LonghornRacingElectric/BSPD_2023/23-BSPD-ELC/22-ELC-2-01-R1 BOM MOUSER.xlsx

Source: | C:\Users\kaits\Documents\GitHub\2022_hardware\22-ELC-2000 (Controls and Harnessing)\22-ELC-2-06-R1(Appetizer)\20-ELC-2-01-R2(Appetizer).sch
Date: | 2022-01-13 |  | Mouser BSPD BOM |  | Shipping Cost ~$8 | Total Cost: $17.49
Tool: | Eeschema (5.1.10)-1
Component Count: |  | 19
Component |  | Designator | Footprint | Manufacturer |  |  | Manufacturer Pt#: | Mouser Pt#: | Quantity: | Quanity w/ Replacements:
1A |  | F1 | 1206 | Littelfuse |  |  | 0437001.WR | 530-C1Q1.25 | 1 | 2
LM239 |  | U1, U2, U5 | SO-14 | STMicroelectronics |  |  | LM239DT | 511-LM239DT | 4 | 6
74HC04 |  | U7 | SOIC-14_3.9x8.7x1.27P | Texas Instruments |  |  | CD40106BM96 | 595-CD40106BM96 | 2 | 3
IMP810JEUR_T |  | VR1 | SOT-23-3 | Daily Silver Imp Microelectronics |  |  | IMP810LEUR/T | 453-DIO6810RST3 | 1 | 2
CD4043BDRG4 |  | U10 | SOIC-16_3.9x9.9x1.27P | Texas Instruments |  |  | CD4043BDRG4 | 595-CD4043BDRG4 | 1
R_POT_TRIM |  | RV1, RV2, RV3, RV4, RV5, RV6, RV7, RV8, RV24, RV27, RV29, RV32 | 3269Wl | Bourns |  |  | PVG5A104C03R00 | 81-PVG5A104C03R00 | 12 | 16
Pin Headers |  | J1, J2 | Connector_PinHeader_2.54mm:PinHeader_1x05_P2.54mm_Vertical | Harwin |  |  | M20-9990945 | 855-M20-9990945 | 1 | 5
