LonghornRacingElectric/BSPD_2023/23-BSPD-ELC/20-ELC-2-06-R2(Appetizer)_layout.pdf

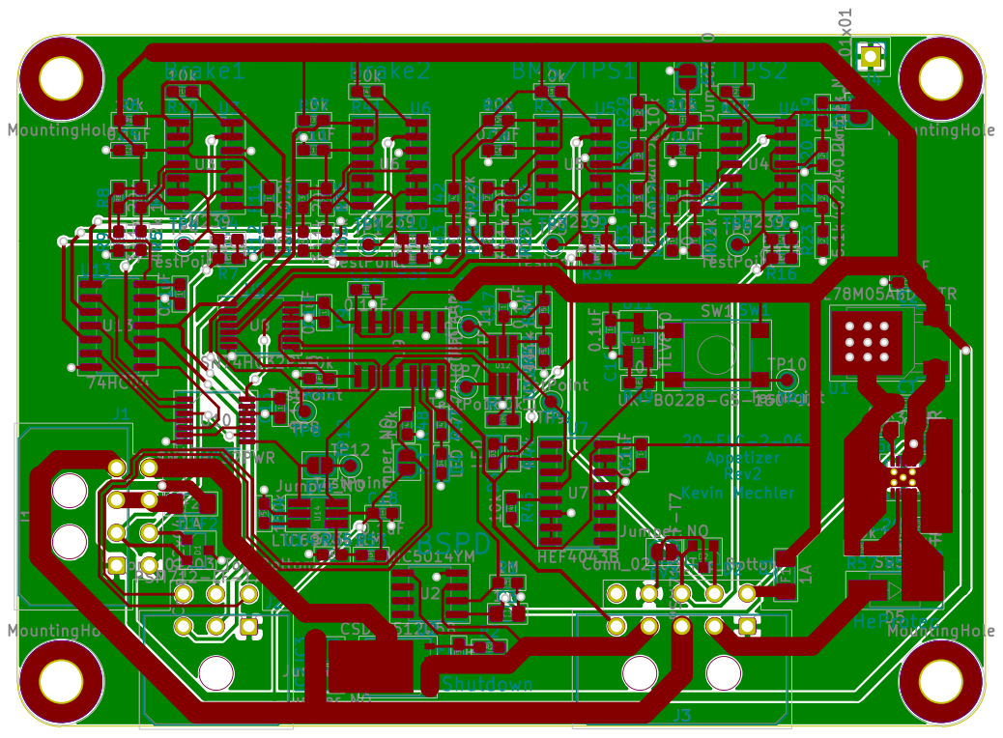
[picture p11: page 1]
