LonghornRacingElectric/BSPD_2023/23-BSPD-ELC/Short_Detector.asc

C1: cap; 0.1µf
C2: cap; 0.1µf
C3: cap; 0.1µf
C4: cap; 0.0014µf
D1: diode; 1N4148
Q1: npn
R1: res; 1k
R2: res; 10k
R3: res; 1Mega
R4: res; 425k
R5: res; 200k
R6: res; 51k
R7: res; 22k
R8: res; 50
R9: res; 2k
U1: LT1716
U2: NE555
V1: voltage; PULSE(0 5 0 100ns 100ns 0.1ms 0.2ms 1000)
V2: voltage; 5
V3: voltage; 5
V4: voltage; 5
V5: voltage; PULSE(0 5 0 100ns 100ns 300ms 600ms)
Named nets: 0
.tran 3s
