LonghornRacingElectric/BSPD_2023/23-BSPD-ELC/20-ELC-2-01-R2(Appetizer).kicad_pcb

## KiCad design 23-BSPD-ELC/20-ELC-2-01-R2(Appetizer).kicad_pcb (2023-01-10)

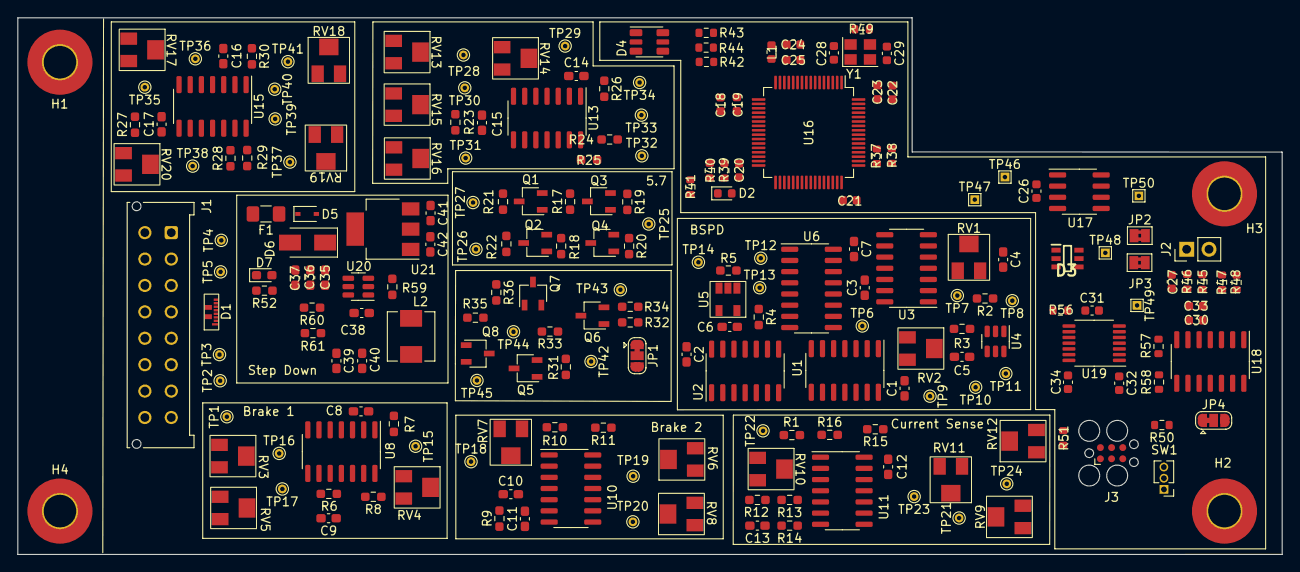
[picture p12: board 20-ELC-2-01-R2(Appetizer).kicad_pcb from above]

Board: 2 copper layers, 143.6 x 61.0 mm, 218 parts (0 on the bottom side), 109 nets, no tracks yet.

Parts:
C1, C2, C3, C6, C7, C8, C9, C10, C11, C12, C13, C14, C15, C16, C17: 0.1uF; C_0603_1608Metric_Pad1.08x0.95mm_HandSolder
C4, C5, C39, C40, C42: 22uF; C_0603_1608Metric_Pad1.08x0.95mm_HandSolder
C18: 4u7; C_0603_1608Metric
C19, C20, C21, C22, C23: 100n; C_0603_1608Metric
C24: 1u; C_0603_1608Metric
C25: 10n; C_0603_1608Metric
C26: 0u1; C_0603_1608Metric
C27: 4.7n; C_0603_1608Metric
C28, C29: 10p; C_0603_1608Metric
C30, C32, C34: .1uF; C_0603_1608Metric
C31: 1uF; C_0603_1608Metric
C33: 10uF; C_0603_1608Metric
C35, C36: 10uF; C_0603_1608Metric_Pad1.08x0.95mm_HandSolder
C37, C38: 100nF; C_0603_1608Metric_Pad1.08x0.95mm_HandSolder
C41: 1uF; C_0603_1608Metric_Pad1.08x0.95mm_HandSolder
D1: ESD7016MUTAG
D2: RED; LED_0603_1608Metric
D3: DT1446-04TS-7; SOT95P280X100-6N
D4: SMLVN6RGB; LED_ROHM_SMLVN6
D5: 32V; D_SOD-323
D6: 0.7dV; D_SMA
D7: LED; LED_0603_1608Metric_Pad1.05x0.95mm_HandSolder
F1: 2A; Fuse_1206_3216Metric_Pad1.42x1.75mm_HandSolder
H1, H2, H3, H4: MountingHole; MountingHole_3.7mm_Pad_TopBottom
J1: Conn_02x08_Counter_Clockwise; Molex_Micro-Fit_3.0_43045-1612_2x08_P3.00mm_Vertical
J2: Conn_01x02; PinHeader_1x02_P2.54mm_Vertical
J3: SWD; Tag-Connect_TC2030-IDC-FP_2x03_P1.27mm_Vertical
JP1, JP4: Jumper_3_Bridged12; SolderJumper-3_P1.3mm_Bridged12_RoundedPad1.0x1.5mm
JP2, JP3: SolderJumper-2_P1.3mm_Bridged2Bar_Pad1.0x1.5mm
L1: 68n; L_0603_1608Metric
L2: 4u7; L_Sunlord_MWSA0518_5.4x5.2mm
Q1, Q2: Q_PMOS_GSD; TSOT-23
Q3, Q4, Q5, Q6: Q_NMOS_GSD-Device; TSOT-23
Q7, Q8: Q_PMOS_DSG; TSOT-23
R1, R2, R3, R4, R7, R8, R10, R11, R15, R16, R17, R19, R20, R21, R22, R24, R25, R26, R28, R29, R30, R33, R34, R35, R36: 10k; R_0603_1608Metric_Pad0.98x0.95mm_HandSolder
R5: 100k; R_0603_1608Metric_Pad0.98x0.95mm_HandSolder
R6, R9, R12: 510k; R_0603_1608Metric_Pad0.98x0.95mm_HandSolder
R13, R14: 150; R_0603_1608Metric_Pad0.98x0.95mm_HandSolder
R18: 250; R_0603_1608Metric_Pad0.98x0.95mm_HandSolder
R23, R27: 510; R_0603_1608Metric_Pad0.98x0.95mm_HandSolder
R31, R32: 25; R_0603_1608Metric_Pad0.98x0.95mm_HandSolder
R37, R38, R39, R40: 2k2; R_0603_1608Metric
R41: 100; R_0603_1608Metric
R42, R43, R44: 220; R_0603_1608Metric
R45, R46, R47, R48: 120; R_0603_1608Metric
R49: 47; R_0603_1608Metric
R50: 10K; R_0603_1608Metric
R51: 22; R_0603_1608Metric
R52: 470R; R_0603_1608Metric_Pad0.98x0.95mm_HandSolder
R56: 100k; R_0603_1608Metric
R57, R58: 10k; R_0603_1608Metric
R59, R60: 10K; R_0603_1608Metric_Pad0.98x0.95mm_HandSolder
R61: 54.9K; R_0603_1608Metric_Pad0.98x0.95mm_HandSolder
RV1, RV2, RV3, RV4, RV5, RV6, RV7, RV8, RV9, RV10, RV11, RV12: PVG5A104C03R00; PVG5A
RV13, RV14, RV17, RV18: 10k; PVG5A
RV15, RV16, RV19, RV20: R_POT_TRIM-Device; PVG5A
SW1: SW_SPDT; PinHeader_1x03_P1.27mm_Vertical
TP1, TP2, TP3, TP4, TP5, TP26, TP27, TP42, TP43, TP44, TP45: TestPoint-Connector; TestPoint_THTPad_D1.0mm_Drill0.5mm
TP6, TP7, TP8, TP9, TP10, TP11, TP12, TP13, TP14, TP15, TP16, TP17, TP18, TP19, TP20, TP21, TP22, TP23, TP24, TP25, TP28, TP29, TP30, TP31, TP32, TP33, TP34, TP35, TP36, TP37, TP38, TP39, TP40, TP41: TestPoint; TestPoint_THTPad_D1.0mm_Drill0.5mm
TP46, TP47, TP48, TP49, TP50: TestPoint_THTPad_1.0x1.0mm_Drill0.5mm
U1: SN74ALS32DR; SOIC-14_3.9x8.7mm_P1.27mm
U2: 74HC04D,653; SO-14_3.9x8.65mm_P1.27mm
U3: 74HC08D,653; SOIC-14_3.9x8.7mm_P1.27mm
U4: 74LVC2G17DBVE4; SOT-23-6
U5: APX823-44W5G-7; AXP823-44W5G-7
U6: CD4043BDR; SOIC-16_3.9x9.9mm_P1.27mm
U8, U10, U11, U13, U15: LM239; SO-14_3.9x8.65mm_P1.27mm
U16: STM32F105RCTx; LQFP-64_10x10mm_P0.5mm
U17: SN65HVD230; SOIC-8_3.9x4.9mm_P1.27mm
U18: MCP3428; SOIC-14_3.9x8.7mm_P1.27mm
U19: LSF0204QPWRQ1; TSSOP-14_4.4x5mm_P0.65mm
U20: LMR51420; SOT-23-6
U21: AMS1117-3.3; SOT-223-3_TabPin2
Y1: 16MHz; Crystal_SMD_3225-4Pin_3.2x2.5mm

Connections:
+3.3VA: C24.1, C25.1, L1.2, U16.13 (VDDA)
+3V3: C18.1, C19.1, C20.1, C21.1, C22.1, C23.1, C26.1, C32.1, C42.1, D2.2 (A), D4.1 (BA), D4.2 (RA), D4.3 (GA), J3.1, L1.1, R37.1, R38.1, R39.1, R40.1, R56.2, SW1.1 (A), U16.1 (VBAT), U16.19 (VDD), U16.32 (VDD), U16.48 (VDD), U16.64 (VDD), U17.3 (VCC), U19.1 (VREF_A), U21.2 (VO)
+5V: C1.1, C2.1, C3.1, C6.1, C7.1, C8.1, C10.1, C12.1, C14.1, C16.1, C30.1, C33.1, C34.1, C39.1, C40.1, C41.1, D3.5 (VCC), L2.2, R4.2, R7.2, R8.1, R10.2, R11.1, R15.2, R16.1, R24.1, R25.1, R26.1, R28.1, R29.1, R30.1, R57.2, R58.2, R61.2, RV3.1, RV4.1, RV5.1, RV6.1, RV7.1, RV8.1, RV9.1, RV10.1, RV11.1, RV12.1, RV13.1, RV14.1, RV15.1, RV16.1, RV17.1, RV18.1, RV19.1, RV20.1, U1.14 (VCC), U2.14 (VCC), U3.14 (Vcc), U4.5 (VCC), U5.5 (Vcc), U6.16 (Vdd), U8.3 (V+), U10.3 (V+), U11.3 (V+), U13.3 (V+), U15.3 (V+), U18.6 (VDD), U19.14 (VREF_B), U21.3 (VI)
+24V: F1.2, J1.1
/5.7/APPS_Trip: Q3.1 (G), Q4.1 (G), R19.2, R20.2, TP25.1, U16.40 (PC9)
/5.7/APPs1_Out: Q1.3 (D), R21.2, TP27.1
/5.7/APPs2_Out: Q2.3 (D), R22.2, TP26.1
/5.7/microcontroller/BOOT0: R50.2, U16.60 (BOOT0)
/5.7/microcontroller/CAN1_RX: TP47.1, U16.61 (PB8), U17.4 (R)
/5.7/microcontroller/CAN1_TX: TP46.1, U16.62 (PB9), U17.1 (D)
/5.7/microcontroller/HSE_in: C28.1, U16.5 (PD0), Y1.1
/5.7/microcontroller/HSE_out: R49.1, U16.6 (PD1)
/5.7/microcontroller/I2C1_SCL: R37.2, U16.58 (PB6)
/5.7/microcontroller/I2C1_SDA: R38.2, U16.59 (PB7)
/5.7/microcontroller/I2C2_SCL: R39.2, U16.29 (PB10)
/5.7/microcontroller/I2C2_SDA: R40.2, U16.30 (PB11)
/5.7/microcontroller/LED_B: R42.2, U16.16 (PA2)
/5.7/microcontroller/LED_G: R43.2, U16.15 (PA1)
/5.7/microcontroller/LED_R: R44.2, U16.14 (PA0)
/5.7/microcontroller/SWCLK: J3.4, U16.49 (PA14)
/5.7/microcontroller/SWDIO: R51.2, U16.46 (PA13)
/24 to 5V Step Down/BUCK/EN: R59.2, U20.5 (EN)
/24 to 5V Step Down/BUCK/SW: C38.1, L2.1, U20.2 (SW)
/24 to 5V Step Down/BUCK/VBST: C38.2, U20.6 (VBST)
/24 to 5V Step Down/BUCK/VFB: R60.1, R61.1, U20.4 (VFB)
/24 to 5V Step Down/BUCK/V_in: C35.1, C36.1, C37.1, D6.1 (K), D7.2 (A), R59.1, U20.3 (VIN)
/24 to 5V Step Down/DIODE: D5.1 (K), D6.2 (A), F1.1
/APPs1_5%: R25.2, TP32.1, U13.14, U16.39 (PC8)
/APPs1_25%: R24.2, TP33.1, U13.13, U16.10 (PC2)
/APPs1_Connected: R26.2, TP34.1, U13.1, U13.2, U16.38 (PC7)
/APPs1_Signal_Raw: C15.1, D1.7 (I/O5), J1.2, Q1.2 (S), R17.2, R23.1, TP4.1, U13.5 (+), U13.6 (-), U13.8 (-), U13.11 (+)
/APPs2_5%: R29.2, TP39.1, U15.14, U16.8 (PC0)
/APPs2_25%: R28.2, TP40.1, U15.13, U16.11 (PC3)
/APPs2_Connected: R30.2, TP41.1, U15.1, U15.2, U16.37 (PC6)
/APPs2_Signal_Raw: C17.1, D1.8 (I/O6), J1.3, Q2.2 (S), R18.2, R27.1, TP5.1, U15.5 (+), U15.6 (-), U15.8 (-), U15.11 (+)
/BMS Signal/DataRaw_Half: R13.1, R14.1, U11.5 (+), U11.6 (-), U11.9 (+), U11.10 (-)
/BSPD_Reset: J1.7, U5.3 (~MR)
/Brake1 Signal/Vref_4V: RV3.2, TP16.1, U8.7 (+), U8.11 (+)
/Brake1_Connected: R8.2, U2.1, U8.13, U8.14
/Brake1_Signal: J1.15, R7.1, U1.1, U8.1, U8.2, U16.25 (PC5)
/Brake1_Signal_Raw: C9.1, D1.4 (I/O3), J1.4, R6.2, TP2.1, U8.5 (+), U8.6 (-), U8.9 (+), U8.10 (-)
/Brake2 Signal/Vref_4V: RV6.2, TP19.1, U10.7 (+), U10.11 (+)
/Brake2_Connected: R11.2, U2.3, U10.13, U10.14
/Brake2_Signal: R10.1, U1.2, U2.9, U10.1, U10.2, U16.24 (PC4)
/Brake2_Signal_Raw: C11.1, D1.2 (I/O2), J1.5, R9.2, TP1.1, U10.5 (+), U10.6 (-), U10.9 (+), U10.10 (-)
/BrakeSystemPlausibilityDevice/Power_and_Brakes: RV1.1, TP7.1, U3.3 (1Y)
/BrakeSystemPlausibilityDevice/Power_and_Brakes_TRIP: TP11.1, U1.4, U4.6
/BrakeSystemPlausibilityDevice/SET: R5.1, TP13.1, U5.1 (~Reset), U6.4 (S1)
/BrakeSystemPlausibilityDevice/Signal_Lost: RV2.1, U1.11
/BrakeSystemPlausibilityDevice/Signal_Lost_TRIP: TP10.1, U1.5, U4.4
/BrakeSystemPlausibilityDevice/TRIP: TP12.1, U1.6, U6.3 (R1)
/BrakeSystemPlausibilityDevice/~Brake1_Connected: U1.9, U2.2
/BrakeSystemPlausibilityDevice/~Brake2_Connected: U1.10, U2.4
/BrakeSystemPlausibilityDevice/~Brake_Connected: U1.8, U1.12
/BrakeSystemPlausibilityDevice/~CS_Connected: U1.13, U2.6
/CurrentSense_Connected: R15.1, U2.5, U11.13, U11.14
/CurrentSense_Signal: R1.1, R16.2, U3.1 (1A), U11.1, U11.2
/Current_Sense_Signal_Raw: C13.1, D1.1 (I/O1), J1.6, R12.2, R13.2, TP3.1
/Shutdown_IN: J1.11, Q7.3 (D), R36.1
/Shutdown_OUT: J1.10, Q8.2 (S), TP45.1
/VCU_Control: J1.9, JP1.3 (B)
/Watchdog/SCL: R58.1, U18.8 (SCL)
/Watchdog/SDA: R57.1, U18.7 (SDA)
/~BSPD_TRIPPED: JP1.1 (A), R32.1, TP14.1, U6.2 (Q1)
/~Brake2_Signal: J1.14, U2.8
GND: C1.2, C2.2, C3.2, C4.2, C5.2, C6.2, C7.2, C8.2, C9.2, C10.2, C11.2, C12.2, C13.2, C14.2, C15.2, C16.2, C17.2, C18.2, C19.2, C20.2, C21.2, C22.2, C23.2, C24.2, C25.2, C26.2, C27.1, C28.2, C29.2, C30.2, C31.2, C32.2, C33.2, C34.2, C35.2, C36.2, C37.2, C39.2, C40.2, C41.2, C42.2, D1.3 (VBUS_OR_GND), D3.2 (VSS), D5.2 (A), J1.8, J3.5, Q3.2 (S), Q4.2 (S), Q6.2 (S), R1.2, R2.2, R3.2, R5.2, R6.1, R9.1, R12.1, R14.2, R19.1, R20.1, R21.1, R22.1, R23.2, R27.2, R34.2, R41.2, R52.1, R60.2, RV3.3, RV4.3, RV5.3, RV6.3, RV7.3, RV8.3, RV9.3, RV10.3, RV11.3, RV12.3, RV13.3, RV14.3, RV15.3, RV16.3, RV17.3, RV18.3, RV19.3, RV20.3, SW1.3 (C), U1.7 (GND), U2.7 (GND), U2.11, U2.13, U3.4 (2A), U3.5 (2B), U3.7 (GND), U3.9 (3A), U3.10 (3B), U3.12 (4A), U3.13 (4B), U4.2 (GND), U5.2 (GND), U6.6 (S2), U6.7 (R2), U6.8 (Vss), U6.11 (R3), U6.12 (S3), U6.14 (S4), U6.15 (R4), U8.12 (V-), U10.12 (V-), U11.12 (V-), U13.12 (V-), U15.12 (V-), U16.12 (VSSA), U16.18 (VSS), U16.31 (VSS), U16.47 (VSS), U16.63 (VSS), U17.2 (GND), U17.8 (Rs), U18.2 (CH1-), U18.4 (CH2-), U18.5 (VSS), U18.9 (Adr0), U18.10 (Adr1), U18.12 (CH3-), U18.14 (CH4-), U19.7 (GND), U20.1 (GND), U21.1 (GND), Y1.2, Y1.4
unnamed: C4.1, R2.1, RV1.2, TP8.1, U4.1
unnamed: C5.1, R3.1, RV2.2, TP9.1, U4.3
unnamed: C27.2, J2.1, R45.1, R46.1
unnamed: C29.1, R49.2, Y1.3
unnamed: C31.1, R56.1, U19.8 (EN)
unnamed: D2.1 (K), R41.1
unnamed: D3.4 (I/O3), JP3.1 (A), R45.2, R46.2, TP49.1, U17.6 (CANL)
unnamed: D3.6 (I/O4), JP2.1 (A), R47.1, R48.1, TP48.1, TP50.1, U17.7 (CANH)
unnamed: D4.4 (GK), R44.1
unnamed: D4.5 (RK), R43.1
unnamed: D4.6 (BK), R42.1
unnamed: D7.1 (K), R52.2
unnamed: J2.2, R47.2, R48.2
unnamed: J3.2, R51.1
unnamed: JP1.2 (C), R31.1
unnamed: JP4.2 (C), U19.3 (A2)
unnamed: Q1.1 (G), Q3.3 (D), R17.1
unnamed: Q2.1 (G), Q4.3 (D), R18.1
unnamed: Q5.1 (G), R31.2, R33.1, TP42.1
unnamed: Q5.2 (S), R33.2
unnamed: Q5.3 (D), Q8.1 (G), R35.2
unnamed: Q6.1 (G), R32.2, R34.1, TP43.1
unnamed: Q6.3 (D), Q7.1 (G), R36.2
unnamed: Q7.2 (S), Q8.3 (D), R35.1, TP44.1
unnamed: R4.1, U6.5 (Enable)
unnamed: R50.1, SW1.2 (B)
unnamed: RV4.2, TP15.1, U8.4 (-)
unnamed: RV5.2, TP17.1, U8.8 (-)
unnamed: RV7.2, TP18.1, U10.4 (-)
unnamed: RV8.2, TP20.1, U10.8 (-)
unnamed: RV9.2, TP21.1, U11.7 (+)
unnamed: RV10.2, TP22.1, U11.4 (-)
unnamed: RV11.2, TP23.1, U11.8 (-)
unnamed: RV12.2, TP24.1, U11.11 (+)
unnamed: RV13.2, TP28.1, U13.7 (+)
unnamed: RV14.2, TP29.1, U13.4 (-)
unnamed: RV15.2, TP30.1, U13.10 (-)
unnamed: RV16.2, TP31.1, U13.9 (+)
unnamed: RV17.2, TP35.1, U15.7 (+)
unnamed: RV18.2, TP36.1, U15.4 (-)
unnamed: RV19.2, TP37.1, U15.10 (-)
unnamed: RV20.2, TP38.1, U15.9 (+)
unnamed: TP6.1, U1.3, U3.2 (1B)
