LonghornRacingElectric/BSPD_2023/23-BSPD-ELC/20-ELC-2-01-R2(Appetizer) - Copy.kicad_pcb

## KiCad design 23-BSPD-ELC/20-ELC-2-01-R2(Appetizer) - Copy.kicad_pcb (2022-11-26, an earlier design)

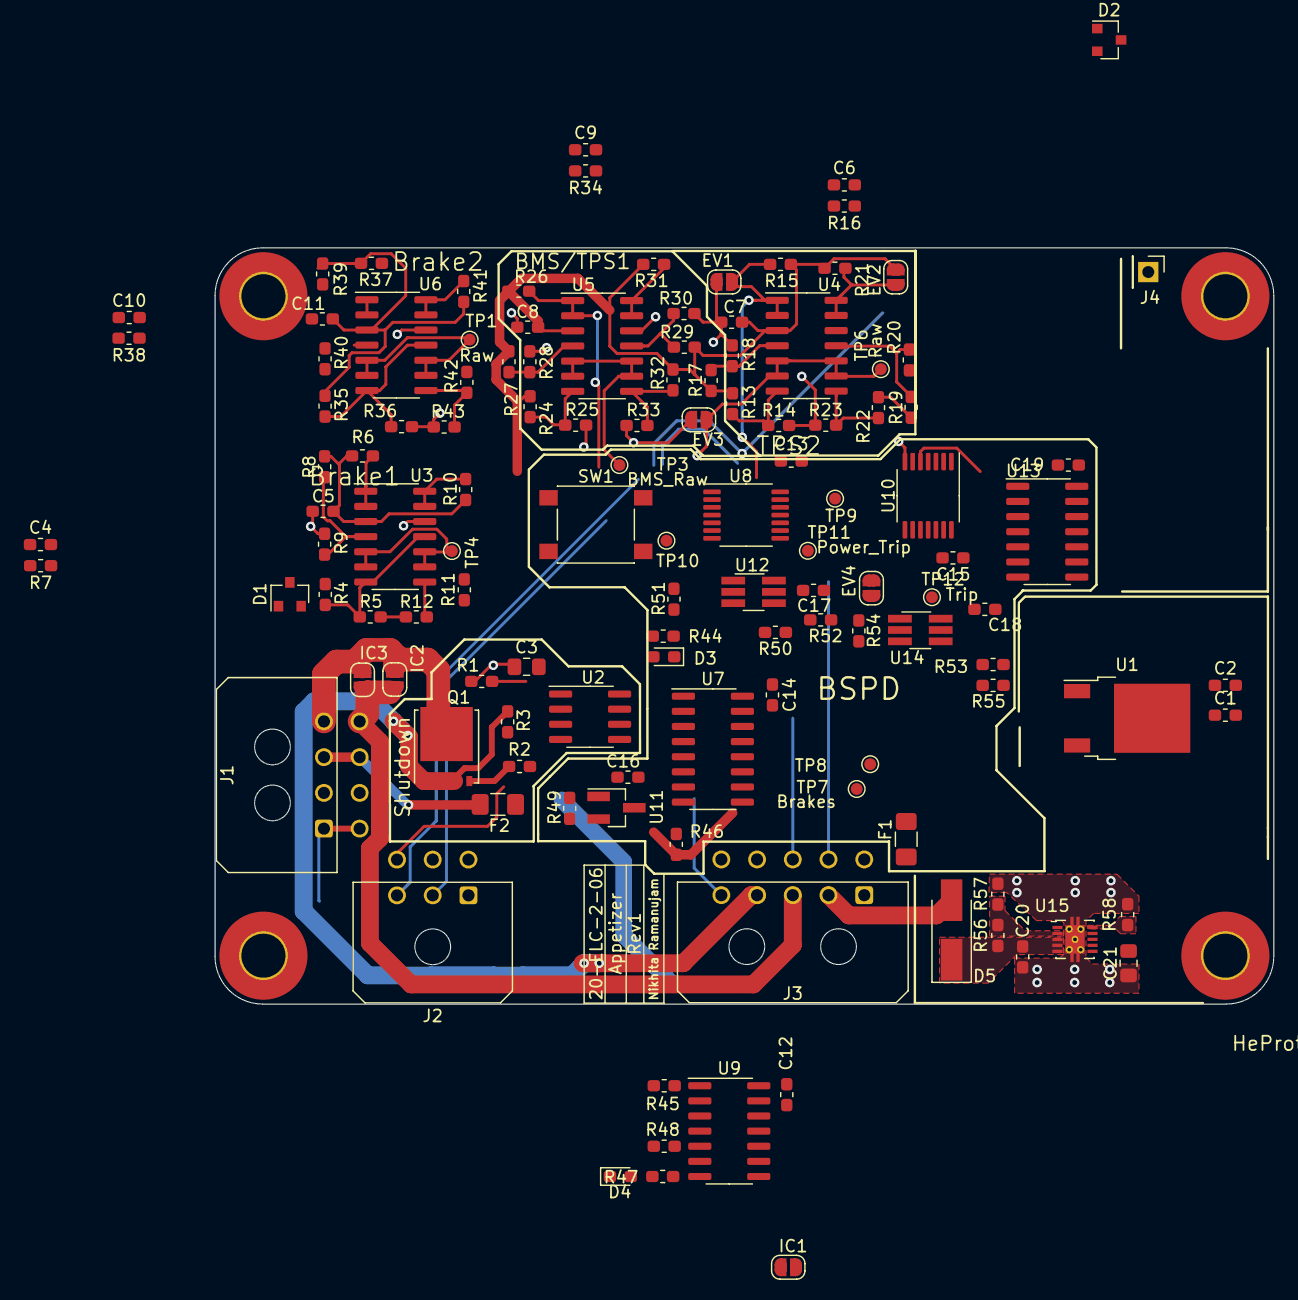
[picture p13: board 20-ELC-2-01-R2(Appetizer) - Copy.kicad_pcb from above]

Board: 2 copper layers, 88.9 x 63.5 mm, 128 parts (0 on the bottom side), 65 nets.

Parts:
C1: 0.33uF; C_0603_1608Metric_Pad1.05x0.95mm_HandSolder
C2, C4, C5, C6, C7, C8, C9, C10, C11, C12, C13, C14, C15, C16, C17, C18, C19, C20: 0.1uF; C_0603_1608Metric_Pad1.05x0.95mm_HandSolder
C3, C21: 1uF; C_0805_2012Metric_Pad1.15x1.40mm_HandSolder
D1, D2: PSM712-LF-T7; SOT-23
D3, D4: LED; LED_0603_1608Metric_Pad1.05x0.95mm_HandSolder
D5: SS54; D_SMA_Handsoldering
EV1, EV2, EV3, EV4: Jumper_NO; SolderJumper-2_P1.3mm_Open_RoundedPad1.0x1.5mm
F1, F2: 1A; Fuse_1206_3216Metric_Pad1.42x1.75mm_HandSolder
H1, H2, H3, H4: MountingHole; MountingHole_3.7mm_Pad_TopBottom
IC1, IC2, IC3: Jumper_NO; SolderJumper-2_P1.3mm_Open_RoundedPad1.0x1.5mm
J1: Conn_02x04_Top_Bottom; Molex_Micro-Fit_3.0_43045-0800_2x04_P3.00mm_Horizontal
J2: Conn_02x03_Top_Bottom; Molex_Micro-Fit_3.0_43045-0600_2x03_P3.00mm_Horizontal
J3: Conn_02x05_Top_Bottom; Molex_Micro-Fit_3.0_43045-1000_2x05_P3.00mm_Horizontal
J4: Conn_01x01; PinHeader_1x01_P2.54mm_Vertical
Q1: CSD18512Q5B; TDSON-8-1
R1, R3, R50, R53: 1M; R_0603_1608Metric_Pad1.05x0.95mm_HandSolder
R2: 220; R_0603_1608Metric_Pad1.05x0.95mm_HandSolder
R4, R6, R10, R12, R13, R15, R21, R24, R26, R29, R31, R33, R35, R37, R41, R43, R45, R46, R48, R49: 10k; R_0603_1608Metric_Pad1.05x0.95mm_HandSolder
R5, R11, R14, R20, R22, R25, R30, R32, R36, R42: 40.2k; R_0603_1608Metric_Pad1.05x0.95mm_HandSolder
R7, R16, R34, R38: 510k; R_0603_1608Metric_Pad1.05x0.95mm_HandSolder
R8, R27, R39: 20k; R_0603_1608Metric_Pad1.05x0.95mm_HandSolder
R9, R28, R40: 30.1k; R_0603_1608Metric_Pad1.05x0.95mm_HandSolder
R17, R18: 0; R_0603_1608Metric_Pad1.05x0.95mm_HandSolder
R19, R23: 5k; R_0603_1608Metric_Pad1.05x0.95mm_HandSolder
R44, R47: 4.7k; R_0603_1608Metric_Pad1.05x0.95mm_HandSolder
R51: 180k; R_0603_1608Metric_Pad1.05x0.95mm_HandSolder
R52: 680k; R_0603_1608Metric_Pad1.05x0.95mm_HandSolder
R54: 150k; R_0603_1608Metric_Pad1.05x0.95mm_HandSolder
R55: 523k; R_0603_1608Metric_Pad1.05x0.95mm_HandSolder
R56: 100k; R_0603_1608Metric_Pad1.05x0.95mm_HandSolder
R57: 25k; R_0603_1608Metric_Pad1.05x0.95mm_HandSolder
R58: 43k; R_0603_1608Metric_Pad1.05x0.95mm_HandSolder
SW1: UK-B0228-G5-160-JZ; SW_Push_1P1T_NO_6x6mm_H9.5mm
TP1, TP3, TP4, TP6, TP7, TP8, TP9, TP10, TP11, TP12: TestPoint; TestPoint_Pad_D1.0mm
U1: L78M05ABDT-TR; TO-252-2
U2: MIC5014YM; SOIC-8_3.9x4.9mm_P1.27mm
U3, U4, U5, U6: LM239; SO-14_3.9x8.65mm_P1.27mm
U7: HEF4043B; SOIC-16_3.9x9.9mm_P1.27mm
U8, U10: SN74HC32PWR; TSSOP-14_4.4x5mm_P0.65mm
U9: 74HC08D,653; SOIC-14_3.9x8.7mm_P1.27mm
U11: TLV810; SOT-23_Handsoldering
U12, U14: LTC6994-1; TSOT-23-6_HandSoldering
U13: 74HC04; SO-14_3.9x8.65mm_P1.27mm
U15: TPS259261DRCR; VSON-10-1EP_3x3mm_P0.5mm_EP1.65x2.4mm_ThermalVias

Connections:
+5V: C2.1, C5.1, C7.1, C8.1, C11.1, C12.1, C13.1, C14.1, C15.2, C16.1, C17.1, C18.1, C19.1, D3.2, EV2.1, F1.2, F2.2, IC1.2, R4.2, R6.2, R8.2, R10.2, R11.2, R13.2, R15.2, R17.2, R19.2, R21.2, R22.2, R24.2, R26.2, R27.2, R29.2, R31.2, R32.2, R35.2, R37.2, R39.2, R41.2, R42.2, R46.2, R50.1, R53.1, SW1.1, U1.3, U3.3, U4.3, U5.3, U6.3, U7.16, U8.14, U9.14, U10.14, U11.3, U12.5, U13.14, U14.5
+12V: C1.2, C3.2, C21.1, U1.1, U2.1, U15.6, U15.7, U15.8
/12V_Raw: D5.2, J3.2
/BMS_or_TPS1_Connected: R31.1, U5.13, U5.14, U13.5
/BMS_or_TPS1_Signal: R26.1, U5.1, U5.2, U8.4
/BMS_or_TPS1_Signal_Raw: C9.1, D2.1, J3.7, R34.2, TP3.1, U5.5, U5.6, U5.9, U5.10
/BOTS-: IC2.2, IC3.2, J1.4, Q1.5
/Brake1 Signal/Vref_4V: R4.1, R5.2, U3.7, U3.11
/Brake1_Connected: R10.1, U3.13, U3.14, U13.1
/Brake1_Signal: J2.2, R6.1, U3.1, U3.2, U8.1, U13.11
/Brake1_Signal_Raw: C4.1, D1.2, J1.2, R7.2, TP4.1, U3.5, U3.6, U3.9, U3.10
/Brake2 Signal/Vref_4V: R35.1, R36.2, U6.7, U6.11
/Brake2_Connected: R41.1, U6.13, U6.14, U13.3
/Brake2_Signal: J2.3, R37.1, U6.1, U6.2, U8.2
/Brake2_Signal_Raw: C10.1, D1.1, J1.6, R38.2, TP1.1, U6.5, U6.6, U6.9, U6.10
/BrakeSystemPlausibilityDevice/BMS_or_Throttle: R45.1, U8.6, U9.1
/BrakeSystemPlausibilityDevice/Brakes_and_Power_TRIP: TP11.1, U8.9, U12.6
/BrakeSystemPlausibilityDevice/Power_and_Brakes: TP7.1, U9.3, U12.1
/BrakeSystemPlausibilityDevice/SET: R49.1, SW1.2, TP10.1, U7.4, U11.2
/BrakeSystemPlausibilityDevice/Signal_Lost: EV4.1, U10.8, U14.1
/BrakeSystemPlausibilityDevice/Signal_Lost_TRIP: EV4.2, TP12.1, U8.10, U14.6
/BrakeSystemPlausibilityDevice/TRIP: TP9.1, U7.3, U8.8
/BrakeSystemPlausibilityDevice/~BMS_or_TPS1_Connected: U10.4, U13.6
/BrakeSystemPlausibilityDevice/~BMS_or_TPS_Connected: U10.6, U10.10
/BrakeSystemPlausibilityDevice/~Brake1_Connected: U10.1, U13.2
/BrakeSystemPlausibilityDevice/~Brake2_Connected: U10.2, U13.4
/BrakeSystemPlausibilityDevice/~Brake_Connected: U10.3, U10.9
/BrakeSystemPlausibilityDevice/~TPS2_Connected: U10.5, U13.8
/Connectors/BOTS+: IC2.1, IC3.1, J1.8, J3.3
/Shutdown_Control: R1.2, R47.2, U2.2, U9.6
/Shutdown_Out: J3.4, Q1.1, Q1.2, Q1.3, R3.1, U2.3
/TPS2_Connected: EV2.2, R21.1, U4.13, U4.14, U13.9
/TPS2_Signal: EV1.1, R15.1, U4.1, U4.2, U8.5
/TPS2_Signal_Raw: C6.1, D2.2, EV3.1, J3.8, R16.2, TP6.1, U4.5, U4.6, U4.9, U4.10
/VCU_Relay_Control: IC1.1, J2.4, R48.1, U9.5
/~BSPD_TRIPPED: J2.6, J3.5, R44.1, U7.2, U9.4
/~Brake1_Signal: J2.5, U13.10
GND: C1.1, C2.2, C3.1, C4.2, C5.2, C6.2, C7.2, C8.2, C9.2, C10.2, C11.2, C12.2, C13.2, C14.2, C15.1, C16.2, C17.2, C18.2, C19.2, C20.2, C21.2, D1.3, D2.3, D4.1, EV1.2, EV3.2, J1.1, J1.5, J2.1, J3.1, J3.9, J4.1, R1.1, R5.1, R7.1, R9.1, R12.1, R14.1, R16.1, R18.1, R20.1, R23.1, R25.1, R28.1, R30.1, R33.1, R34.1, R36.1, R38.1, R40.1, R43.1, R45.2, R48.2, R49.2, R51.2, R52.2, R54.2, R55.2, R57.2, R58.2, U1.2, U2.4, U3.12, U4.12, U5.12, U6.12, U7.6, U7.7, U7.8, U7.11, U7.12, U7.14, U7.15, U8.7, U8.12, U8.13, U9.7, U9.9, U9.10, U9.12, U9.13, U10.7, U10.12, U10.13, U11.1, U12.2, U13.7, U13.13, U14.2, U15.11
unnamed: C20.1, D5.1, R56.1, U15.3, U15.4, U15.5
unnamed: D3.1, R44.2
unnamed: D4.2, R47.1
unnamed: F1.1, J3.6
unnamed: F2.1, J1.3, J1.7
unnamed: Q1.4, R2.1, R3.2
unnamed: R2.2, U2.5
unnamed: R8.1, R9.2, U3.4
unnamed: R11.1, R12.2, U3.8
unnamed: R13.1, R14.2, U4.7
unnamed: R17.1, R18.2, U4.4
unnamed: R19.1, R20.2, U4.11
unnamed: R22.1, R23.2, U4.8
unnamed: R24.1, R25.2, U5.7
unnamed: R27.1, R28.2, U5.4
unnamed: R29.1, R30.2, U5.11
unnamed: R32.1, R33.2, U5.8
unnamed: R39.1, R40.2, U6.4
unnamed: R42.1, R43.2, U6.8
unnamed: R46.1, U7.5
unnamed: R50.2, R52.1, U12.4
unnamed: R51.1, U12.3
unnamed: R53.2, R55.1, U14.4
unnamed: R54.1, U14.3
unnamed: R56.2, R57.1, U15.2
unnamed: R58.1, U15.10
unnamed: TP8.1, U8.3, U9.2
