LonghornRacingElectric/BSPD_2023/(commit log)

2022-11-26 23-BSPD updated schematic. Please ignore the backup files.
    [20-ELC-2-01-R2(Appetizer) - Copy.kicad_pcb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]
2022-12-04 Updated connectors and added ~brake signal to vcu
    [20-ELC-2-01-R2(Appetizer).kicad_sch, Connectors.kicad_sch, bspd.kicad_sch]
2022-12-12 Revision changes and updates to some footprints
    [20-ELC-2-01-R2(Appetizer).kicad_sch, 24to5VStepDown.kicad_sch, 5.7.kicad_sch, APPsComparator.kicad_sch, BMSComparator.kicad_sch, BSPDShutdownCircuit.kicad_sch, BUCK.kicad_sch, BrakeComparator.kicad_sch]
2023-01-07 Updated pcb layout; Watchdog on board still in progress
    [20-ELC-2-01-R2(Appetizer).kicad_pcb, 20-ELC-2-01-R2(Appetizer).kicad_sch, 24to5VStepDown.kicad_sch, 5.7.kicad_sch, APPsComparator.kicad_sch, BMSComparator.kicad_sch, BSPDShutdownCircuit.kicad_sch, BUCK.kicad_sch]
2023-01-10 BSPD layout
    [20-ELC-2-01-R2(Appetizer).kicad_pcb, 20-ELC-2-01-R2(Appetizer).kicad_sch, 24to5VStepDown.kicad_sch, 5.7.kicad_sch, APPsComparator.kicad_sch, BSPDShutdownCircuit.kicad_sch, BUCK.kicad_sch, BrakeComparator.kicad_sch]
